fablabnbg/foodtruck-display/photos/photo_2021-11-25_00-58-04.jpg

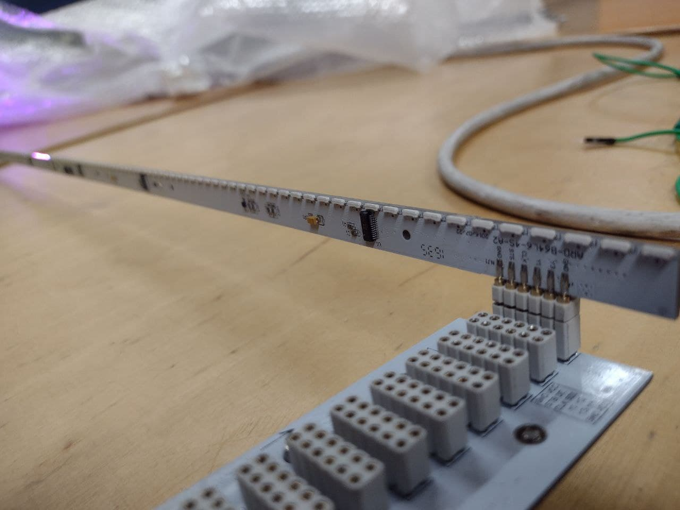
photos/photo_2021-11-25_00-58-04.jpg
