fablabnbg/foodtruck-display/photos/photo_2021-11-25_00-50-22.jpg

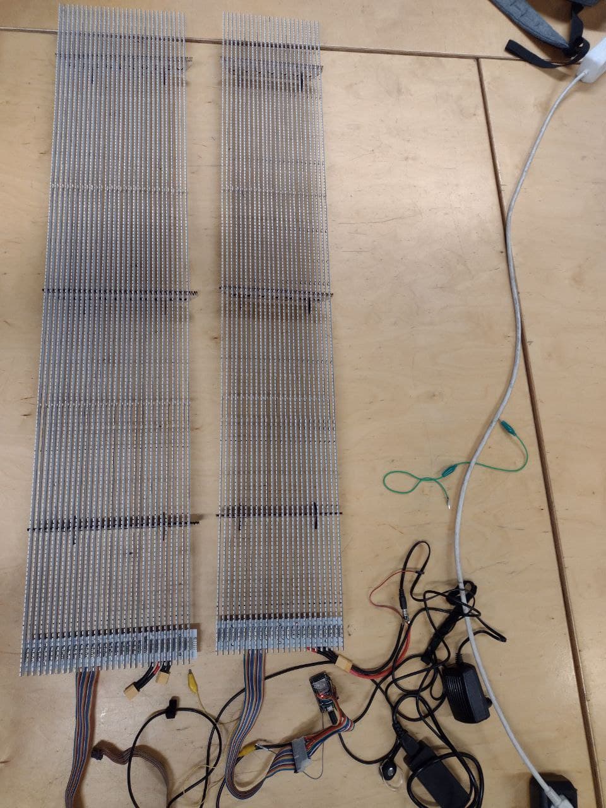
photos/photo_2021-11-25_00-50-22.jpg
