fablabnbg/foodtruck-display/README.md

# foodtruck-display
Reverse engineering efforts for a MRV210-1 driven led display screen with MBI5120
