fablabnbg/foodtruck-display/photos/photo_2021-11-25_00-59-47.jpg

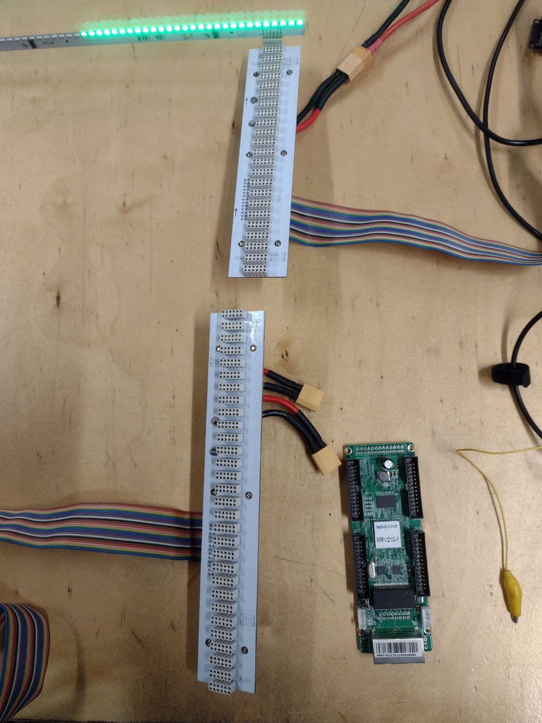
photos/photo_2021-11-25_00-59-47.jpg
