fablabnbg/foodtruck-display/photos/photo_2021-11-25_01-07-27.jpg

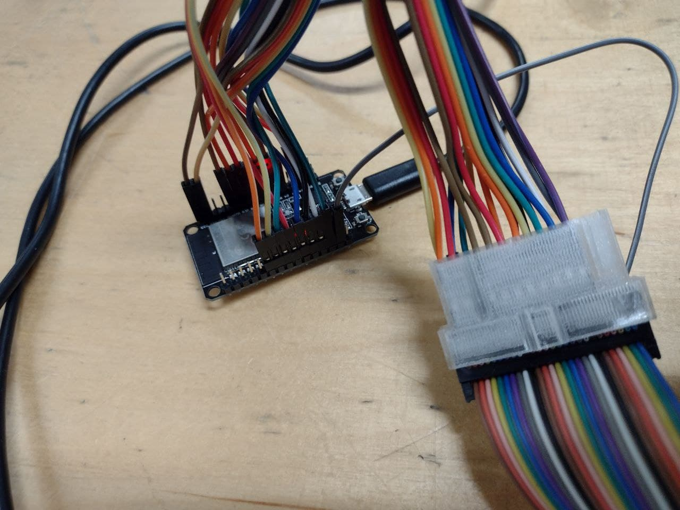
photos/photo_2021-11-25_01-07-27.jpg
