fablabnbg/foodtruck-display/freecad/26pos-jumper-adapter-MRV210-24.FCStd

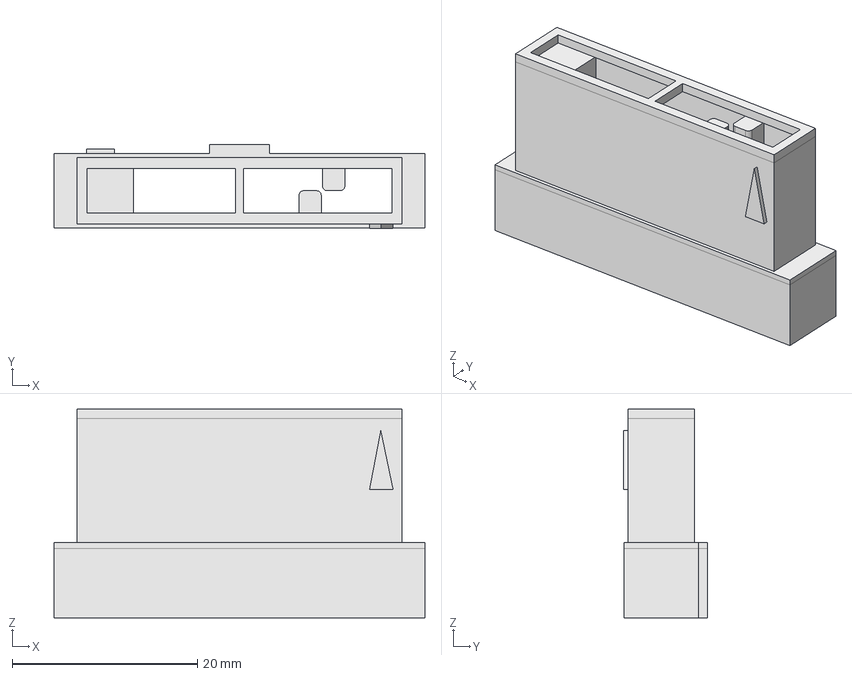
[picture p5: CAD file, 2021-12-12]
freecad/26pos-jumper-adapter-MRV210-24.FCStd
40.0 x 9.09 x 22.5 mm
