fablabnbg/foodtruck-display/freecad/26pos-jumper-adapter-MRV210-30-Body.stl

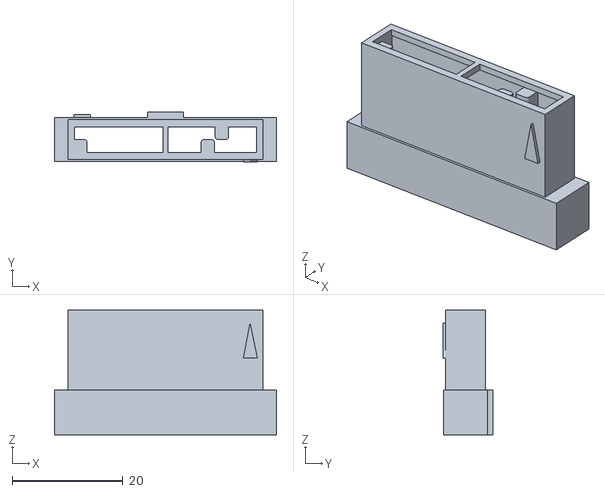
[picture p6: CAD file, 2021-12-12]
freecad/26pos-jumper-adapter-MRV210-30-Body.stl
40.0 x 9.09 x 22.5
