fablabnbg/foodtruck-display/(list of files, cad)

Other CAD files:
freecad/26pos-jumper-adapter-MRV210-24-Body.stl
freecad/26pos-jumper-adapter-MRV210-30.FCStd
