fablabnbg/foodtruck-display/esp32/one-led-row-schematics.pdf

One LED Row Schematics | 2021-11-21, jw

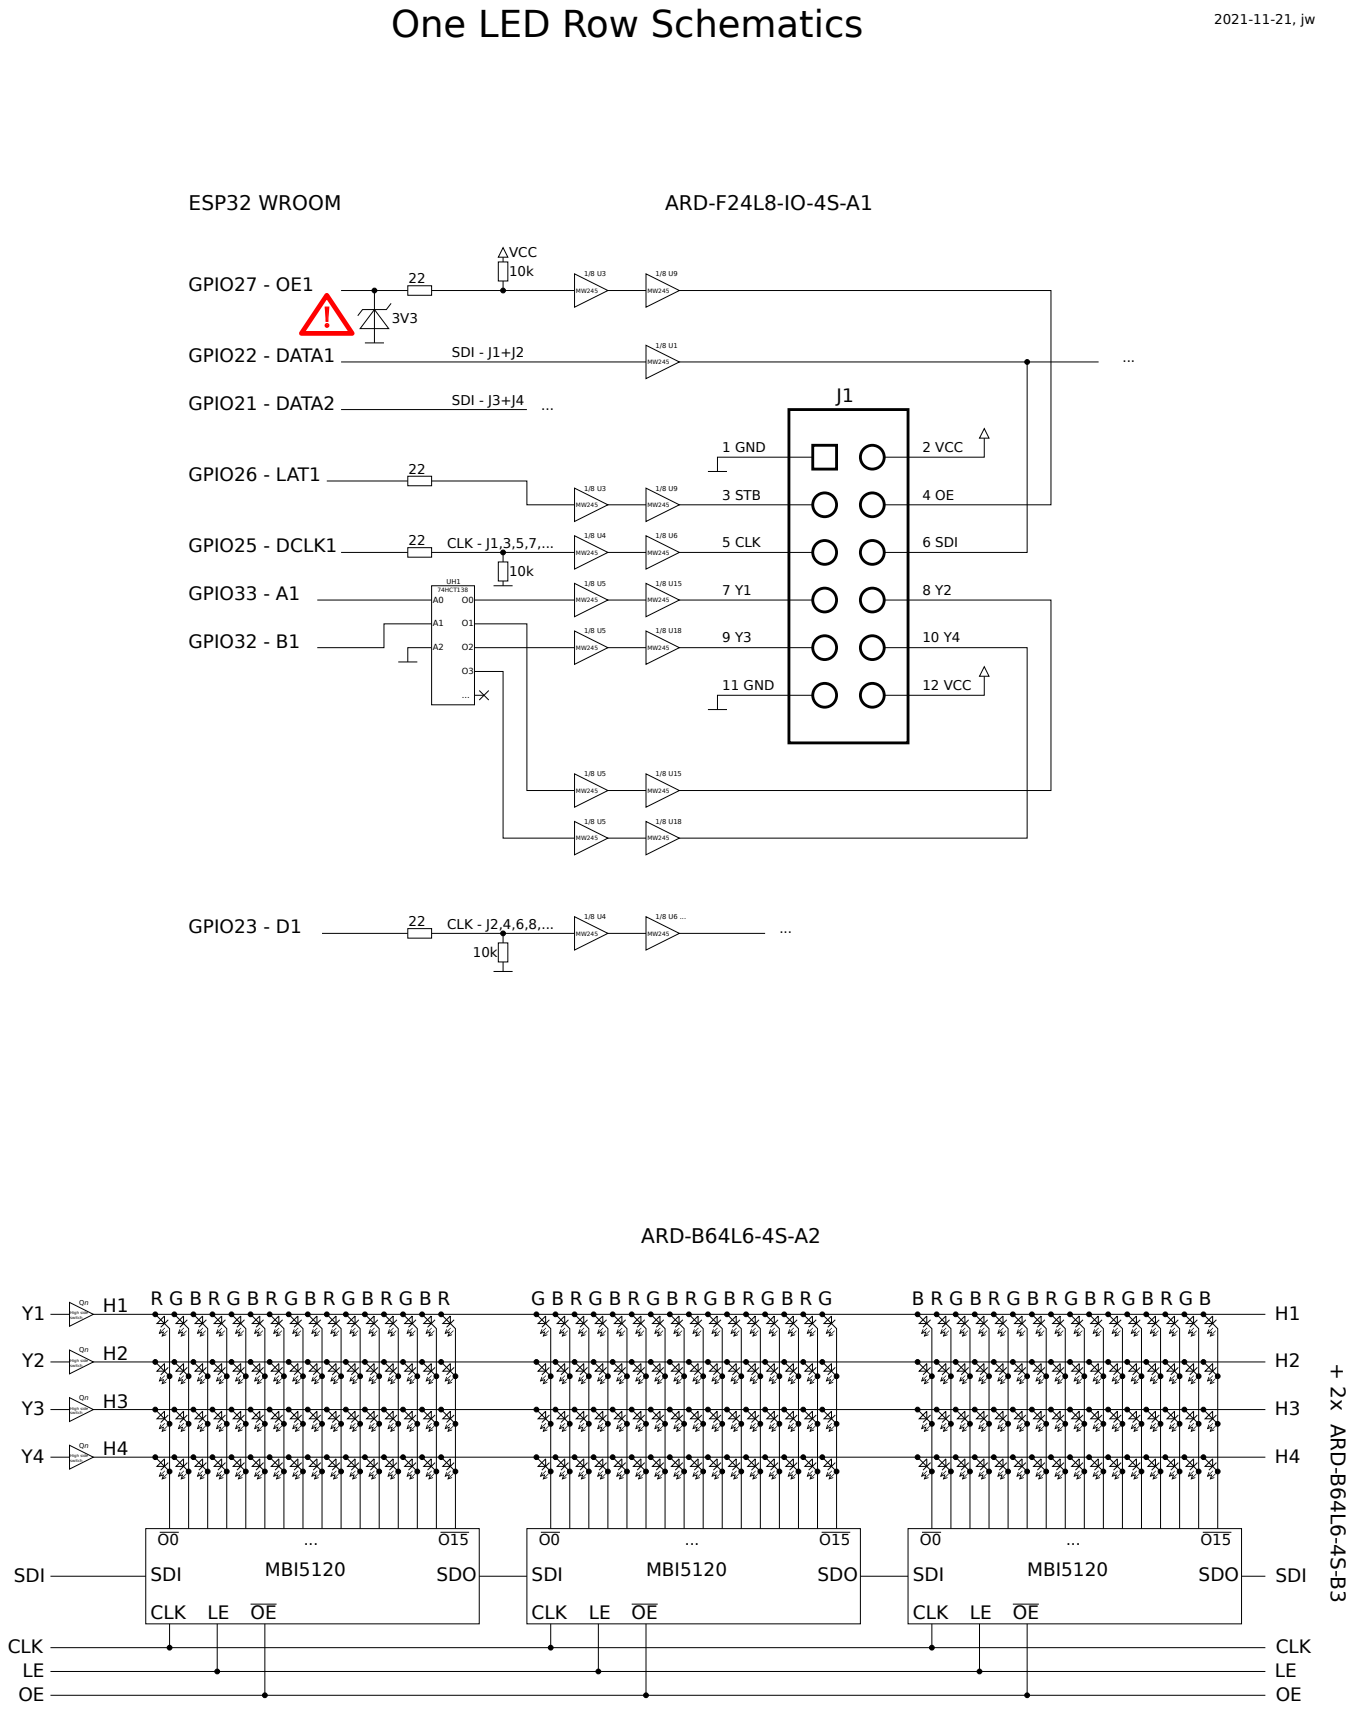
[picture p7: page 1]
