fablabnbg/foodtruck-display/hub-20100729/module-schematics-2020-07-29.pdf

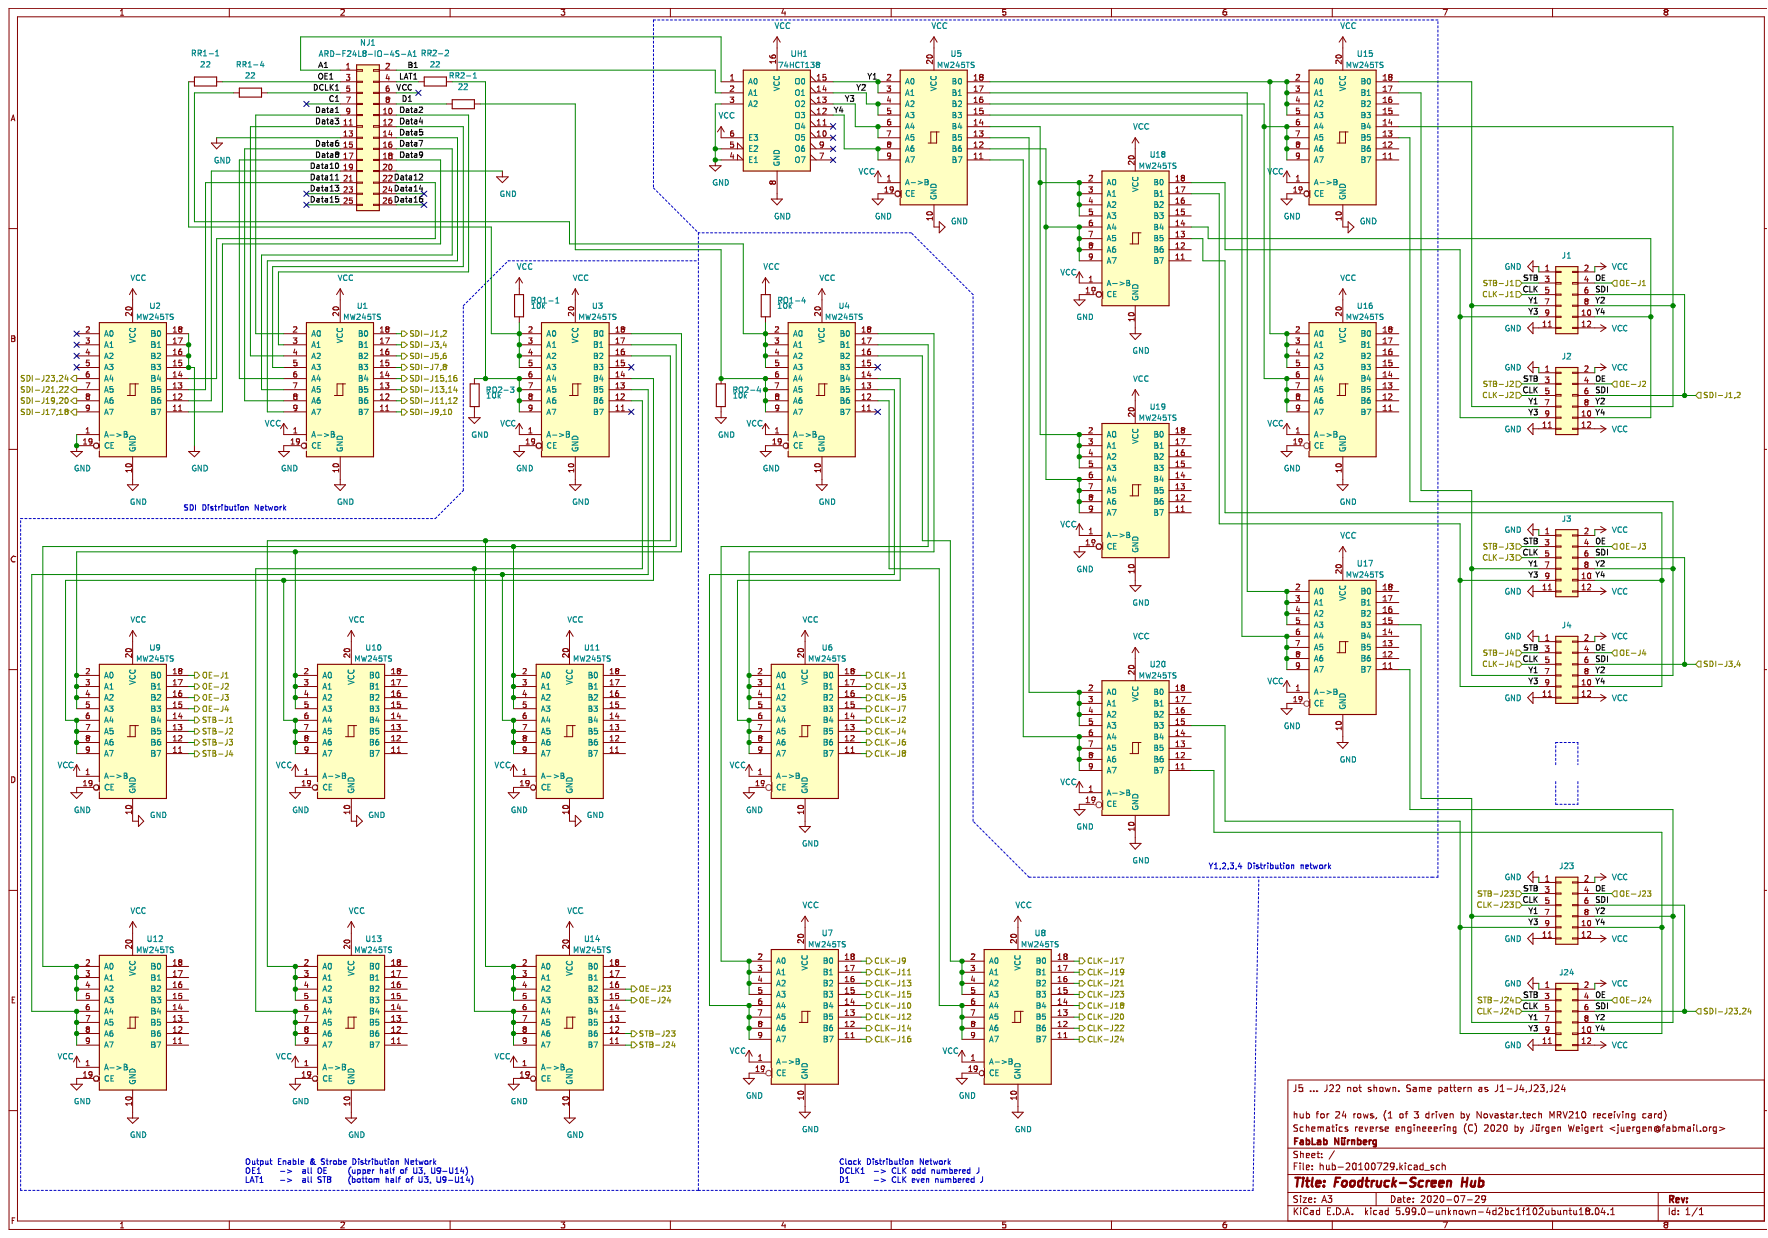
[picture p8: page 1]
