fablabnbg/foodtruck-display/(threads)

Thread 2 (2021-11-25):

One group shows four  LEDs instead of one

jnweiger, 2021-11-25:
Seen with knightrider-ota-jw.ino

Better visible and very consistent with the slower dots.
Three steps with one LED on, then one step with four LEDs on, ...

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
