fablabnbg/foodtruck-display/(commit log)

2021-11-24 First lauflicht done on one row only with an esp32
2021-11-25 esp32 photo with many wires. Also showing the use of https://www.thingiverse.com/thing:4570722
2021-12-12 Added kicad drawing.
    [hub-20100729.kicad_pcb, hub-20100729.kicad_sch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]
